fcte-pi1/2026_1_PI1_Grupo2_Lui/src/frontend/README.md

### 1. Pré-requisitos
Você precisa ter o **Node.js** instalado no seu computador. Ele automaticamente inclui o `npm` (gerenciador de pacotes).
[Caso não tenha, baixe a versão LTS do Node.js aqui.](https://nodejs.org/)

### 2. Instalando as Dependências
Abra o seu terminal/prompt de comando diretamente na raiz desta pasta (`src\frontend`) e rode o seguinte comando:

```bash
npm install
```
*O npm vai ler o `package.json`, e baixar automaticamente o React, Tailwind, Lucide e os scripts necessários, criando a pasta `node_modules`.*

### 3. Rodando o Servidor de Desenvolvimento
Uma vez que as dependências terminaram de baixar, basta "ligar" o dashboard com:

```bash
npm start
```

### 4. Acessando a Interface
O comando anterior compilará a interface e abrirá o seu navegador automaticamente. Se não abrir, basta acessar manualmente:
**[http://localhost:3000](http://localhost:3000)**
