fcte-pi1/2026_1_PI1_Grupo2_Lui/docs/index.md

<canvas id="bgCanvas"></canvas>
<style>
  .presentation-title {
    font-size: 5.8rem !important;
  }

  @media screen and (max-width: 76.1875em) {
    .presentation-title {
      font-size: 4.6rem !important;
    }
  }

  @media screen and (max-width: 480px) {
    .presentation-title {
      font-size: 4rem !important;
    }
  }
</style>

#

<div class="presentation">
  <div class="presentation-tag">
    <span class="presentation-line"></span>
    <span class="presentation-label">Arquitetura de Navegação Autônoma</span>
    <span class="presentation-line"></span>
  </div>

  <div class="presentation-title">Micro<br><span class="presentation-title-fade">Mouse</span></div>

  <div class="presentation-content">
    <div class="presentation-text">
      <p style="font-size: var(--home-fs-lead); color: #94a3b8; font-style: italic; line-height: 1.55;">
        Desenvolvimento de um micromouse: um robô autônomo inteligente capaz de explorar e resolver labirintos desconhecidos com alta eficiência. O projeto integra soluções de <strong style="color: #fff;">Energia</strong>, <strong style="color: #fff;">Estrutura</strong>, <strong style="color: #fff;">Hardware</strong> e <strong style="color: #fff;">Software</strong> para criar uma plataforma robusta de navegação autônoma e monitoramento em tempo real.
      </p>
    </div>
  </div>
</div>

---

## Grupo 02 | Turma Lui

<div class="team-areas">

  <!-- ── SOFTWARE (6) ─────────────────────────── -->
  <section class="team-area team-area--software">
    <header class="team-area__header">
      <div class="team-area__title">Software</div>
      <span class="team-area__count">06</span>
    </header>
    <div class="team-area__grid">

      <a class="team-card team-card--lead" data-area="software" href="https://github.com/arthurrochamoreira">
        <span class="team-card__badge">Gerente de Software</span>
        <div class="team-card__avatar-inner">
          Arthur Moreira
        </div>
        <div class="team-card__body">
          <div class="team-card__name">Arthur Moreira</div>
          <div class="team-card__handle">@arthurrochamoreira</div>
        </div>
      </a>

      <a class="team-card" data-area="software" href="https://github.com/eduardoferre">
        <div class="team-card__avatar-inner">
          Eduardo Ferreira
        </div>
        <div class="team-card__body">
          <div class="team-card__name">Eduardo Ferreira</div>
          <div class="team-card__handle">@eduardoferre</div>
        </div>
      </a>

      <a class="team-card" data-area="software" href="https://github.com/flaviarebelato">
        <div class="team-card__avatar-inner">
          Flávia de Melo
        </div>
        <div class="team-card__body">
          <div class="team-card__name">Flávia de Melo</div>
          <div class="team-card__handle">@flaviarebelato</div>
        </div>
      </a>

      <a class="team-card" data-area="software" href="https://github.com/GabrielDiniz12">
        <div class="team-card__avatar-inner">
          Gabriel Diniz
        </div>
        <div class="team-card__body">
          <div class="team-card__name">Gabriel Diniz</div>
          <div class="team-card__handle">@GabrielDiniz12</div>
        </div>
      </a>

      <a class="team-card" data-area="software" href="https://github.com/gpaulovit">
        <div class="team-card__avatar-inner">
          Paulo Vitor
        </div>
        <div class="team-card__body">
          <div class="team-card__name">Paulo Vitor</div>
          <div class="team-card__handle">@gpaulovit</div>
        </div>
      </a>

      <a class="team-card" data-area="software" href="https://github.com/dev-americo">
        <div class="team-card__avatar-inner">
          Pedro H. A.
        </div>
        <div class="team-card__body">
          <div class="team-card__name">Pedro H. A.</div>
          <div class="team-card__handle">@dev-americo</div>
        </div>
      </a>

    </div>
  </section>

  <!-- ── HARDWARE (5) ─────────────────────────── -->
  <section class="team-area team-area--hardware">
    <header class="team-area__header">
      <div class="team-area__title">Hardware</div>
      <span class="team-area__count">05</span>
    </header>
    <div class="team-area__grid">

      <a class="team-card team-card--lead" data-area="hardware" href="#">
        <span class="team-card__badge">Gerente de Hardware</span>
        <div class="team-card__avatar-inner">
          João Victor Pereira
        </div>
        <div class="team-card__body">
          <div class="team-card__name">João Victor Pereira</div>
          <div class="team-card__handle">@joaovitor</div>
        </div>
      </a>

      <a class="team-card" data-area="hardware" href="https://github.com/arthurlleite">
        <div class="team-card__avatar-inner">
          Arthur Carvalho
        </div>
        <div class="team-card__body">
          <div class="team-card__name">Arthur Carvalho</div>
          <div class="team-card__handle">@arthurlleite</div>
        </div>
      </a>

      <a class="team-card" data-area="hardware" href="https://github.com/menali17">
        <div class="team-card__avatar-inner">
          Enzo Menali
        </div>
        <div class="team-card__body">
          <div class="team-card__name">Enzo Menali</div>
          <div class="team-card__handle">@menali17</div>
        </div>
      </a>

      <a class="team-card" data-area="hardware" href="https://github.com/xLucasMelo">
        <div class="team-card__avatar-inner">
          Lucas Alves
        </div>
        <div class="team-card__body">
          <div class="team-card__name">Lucas Alves</div>
          <div class="team-card__handle">@xLucasMelo</div>
        </div>
      </a>

      <a class="team-card" data-area="hardware" href="https://github.com/pwdrinho">
        <div class="team-card__avatar-inner">
          Pedro Lucas
        </div>
        <div class="team-card__body">
          <div class="team-card__name">Pedro Lucas</div>
          <div class="team-card__handle">@pwdrinho</div>
        </div>
      </a>

    </div>
  </section>

  <!-- ── ENERGIA (4) ─────────────────────────── -->
  <section class="team-area team-area--energia">
    <header class="team-area__header">
      <div class="team-area__title">Energia</div>
      <span class="team-area__count">04</span>
    </header>
    <div class="team-area__grid">

      <a class="team-card team-card--lead" data-area="energia" href="https://github.com/gusmoles">
        <span class="team-card__badge">Gerente de Energia</span>
        <div class="team-card__avatar-inner">
          Guilherme Gusmão
        </div>
        <div class="team-card__body">
          <div class="team-card__name">Guilherme Gusmão</div>
          <div class="team-card__handle">@gusmoles</div>
        </div>
      </a>

      <a class="team-card" data-area="energia" href="https://github.com/cvbmiranda">
        <div class="team-card__avatar-inner">
          Caio Vilas Boas
        </div>
        <div class="team-card__body">
          <div class="team-card__name">Caio Vilas Boas</div>
          <div class="team-card__handle">@cvbmiranda</div>
        </div>
      </a>

      <a class="team-card" data-area="energia" href="#">
        <div class="team-card__avatar-inner">
          Theo Medeiros
        </div>
        <div class="team-card__body">
          <div class="team-card__name">Theo Medeiros</div>
          <div class="team-card__handle">@theomedeiros</div>
        </div>
      </a>

      <a class="team-card" data-area="energia" href="https://github.com/viniiribeiro">
        <div class="team-card__avatar-inner">
          Vinicius Ribeiro
        </div>
        <div class="team-card__body">
          <div class="team-card__name">Vinicius Ribeiro</div>
          <div class="team-card__handle">@viniiribeiro</div>
        </div>
      </a>

    </div>
  </section>

  <!-- ── ESTRUTURAS (3) ─────────────────────────── -->
  <section class="team-area team-area--estruturas">
    <header class="team-area__header">
      <div class="team-area__title">Estruturas</div>
      <span class="team-area__count">03</span>
    </header>
    <div class="team-area__grid">

      <a class="team-card team-card--lead" data-area="estruturas" href="https://github.com/heyclarinham">
        <span class="team-card__badge">Gerente de Projeto</span>
        <div class="team-card__avatar-inner">
          Maria Clara
        </div>
        <div class="team-card__body">
          <div class="team-card__name">Maria Clara</div>
          <div class="team-card__handle">@heyclarinham</div>
        </div>
      </a>

      <a class="team-card team-card--lead" data-area="estruturas" href="https://github.com/luisa747">
        <span class="team-card__badge">Gerente de Estruturas</span>
        <div class="team-card__avatar-inner">
          Luisa Mel
        </div>
        <div class="team-card__body">
          <div class="team-card__name">Luisa Mel</div>
          <div class="team-card__handle">@luisa747</div>
        </div>
      </a>

      <a class="team-card" data-area="estruturas" href="https://github.com/nandjala">
        <div class="team-card__avatar-inner">
          Nandjala
        </div>
        <div class="team-card__body">
          <div class="team-card__name">Nandjala</div>
          <div class="team-card__handle">@nandjala</div>
        </div>
      </a>

    </div>
  </section>

</div>

---

## Referências

GARCIA, Diogo C.; RODRIGUES, Juliana P.; NERI, Hilmer Rodrigues; HABL, Lui T. C.; PEREIRA, Bruno L.
**MicroMouse Project**
*Universidade de Brasília (UnB), Faculdade do Gama (FCTE), 2026.*

## Histórico de versões

| Versão | Data | Descrição | Autor(es) | Revisor(es) | Descrição da Revisão |
| :----: | :---: | :---: | :---: | :---: | :---: |
| `1.0`  | 14/04/2026 | Criação da git page | [Arthur Moreira](https://github.com/arthurrochamoreira) | Pendente |  |
