fcte-pi1/2026_1_PI1_Grupo2_Lui/hw/assets/Figura 1 - Implementação do código de processamento..png

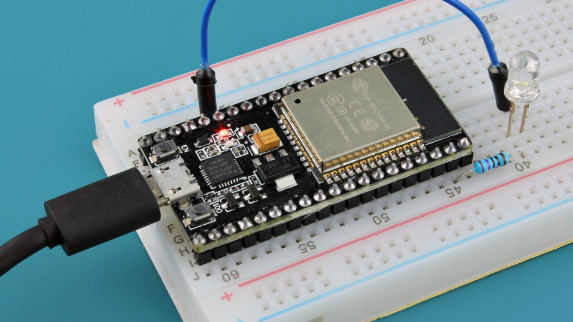
hw/assets/Figura 1 - Implementação do código de processamento..png
