fcte-pi1/2026_1_PI1_Grupo2_Lui/hw/assets/Figura 3 - Diagrama de Estados da FSM implementada no firmware.png

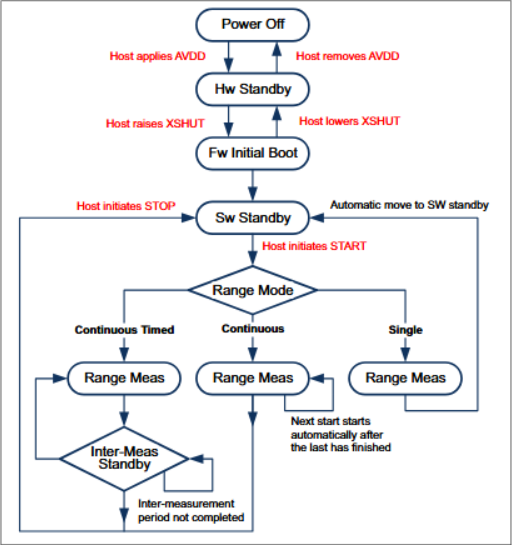
hw/assets/Figura 3 - Diagrama de Estados da FSM implementada no firmware.png
