fcte-pi1/2026_1_PI1_Grupo2_Lui/hw/assets/Figura 4 - Monitor serial distância 3 cm.png

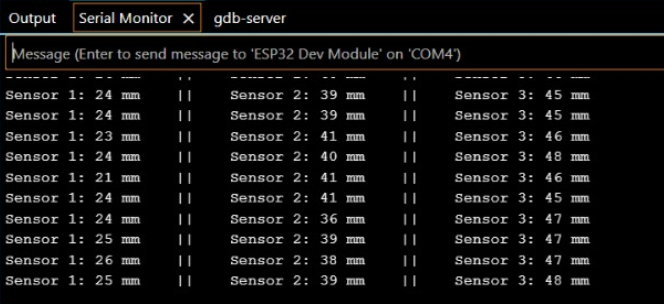
hw/assets/Figura 4 - Monitor serial distância 3 cm.png
