fcte-pi1/2026_1_PI1_Grupo2_Lui/hw/assets/Figura 5 - Monitor serial distância 5 cm.png

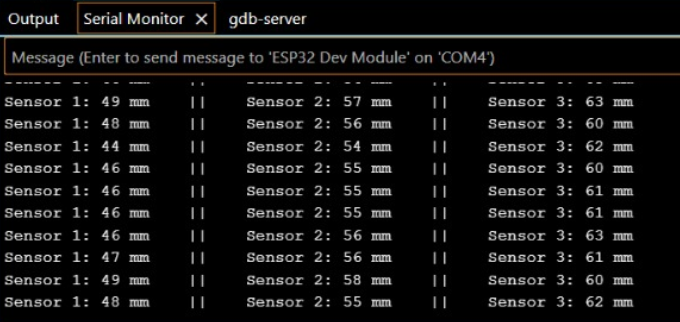
hw/assets/Figura 5 - Monitor serial distância 5 cm.png
