fcte-pi1/2026_1_PI1_Grupo2_Lui/hw/assets/Figura 6 - Monitor serial distância 15 cm.png

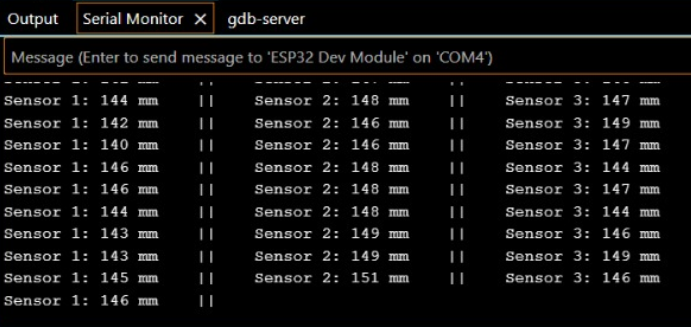
hw/assets/Figura 6 - Monitor serial distância 15 cm.png
