fcte-pi1/2026_1_PI1_Grupo2_Lui/hw/assets/Figura 7 - Monitor serial distância 18 cm.png

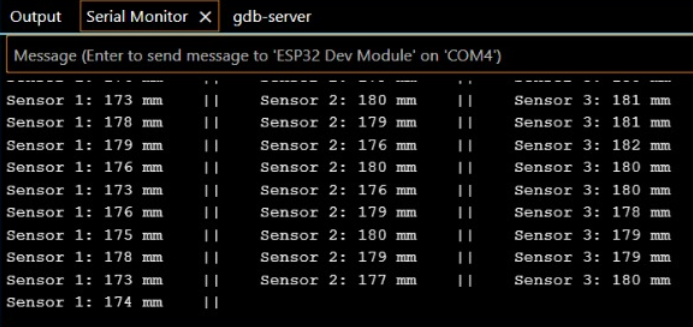
hw/assets/Figura 7 - Monitor serial distância 18 cm.png
