fcte-pi1/2026_1_PI1_Grupo2_Lui/hw/assets/Figura 8 - Monitor serial distância 25 cm.png

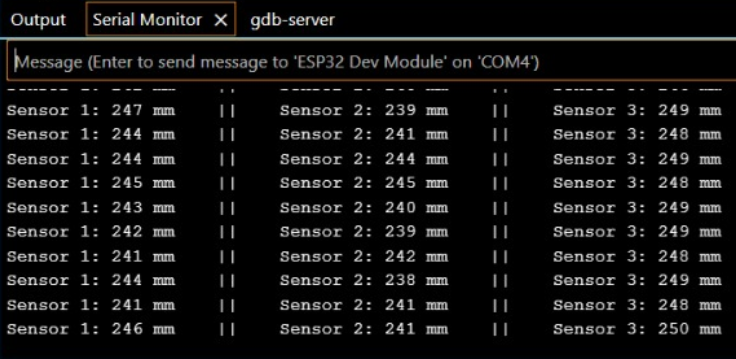
hw/assets/Figura 8 - Monitor serial distância 25 cm.png
