fcte-pi1/2026_1_PI1_Grupo2_Lui/hw/assets/Figura 12 - Diagrama do circuito.png

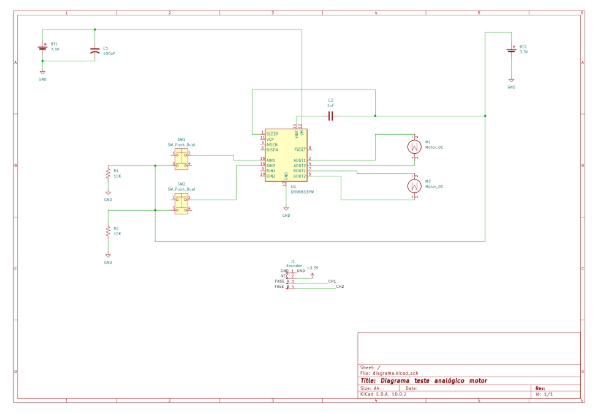
hw/assets/Figura 12 - Diagrama do circuito.png
