fcte-pi1/2026_1_PI1_Grupo2_Lui/hw/assets/Figura 13.1 - Tela do osciloscópio do laboratório.png

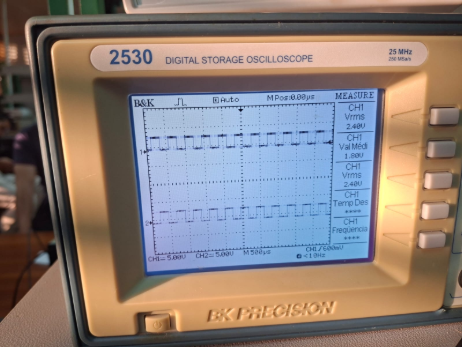
hw/assets/Figura 13.1 - Tela do osciloscópio do laboratório.png
