fcte-pi1/2026_1_PI1_Grupo2_Lui/hw/assets/inicio_codigo.png

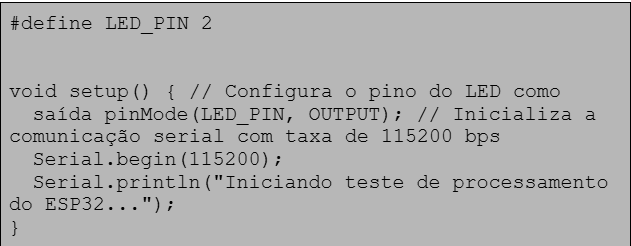
hw/assets/inicio_codigo.png
