fcte-pi1/2026_1_PI1_Grupo2_Lui/hw/assets/loop_codigo.png

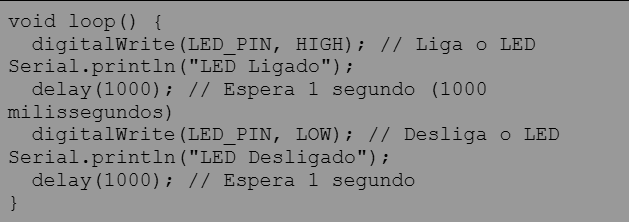
hw/assets/loop_codigo.png
