fcte-pi1/2026_1_PI1_Grupo2_Lui/hw/curva_sharp.jpg

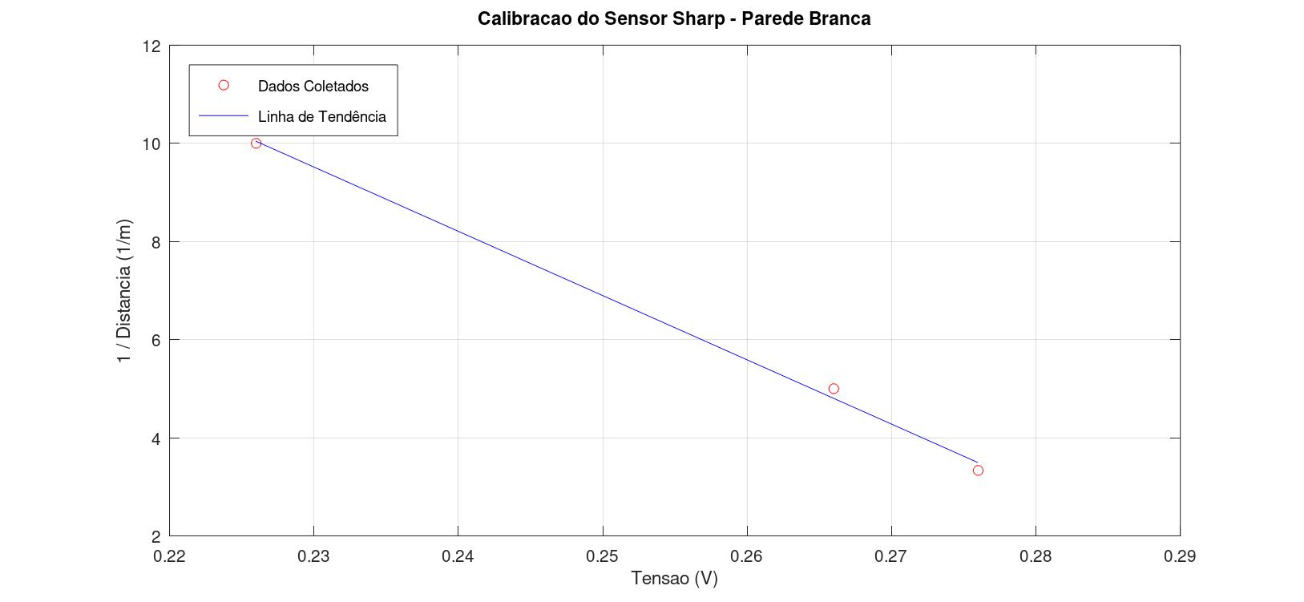
hw/curva_sharp.jpg
