fcte-pi1/2026_1_PI1_Grupo2_Lui/hw/diagrama_bloco.png

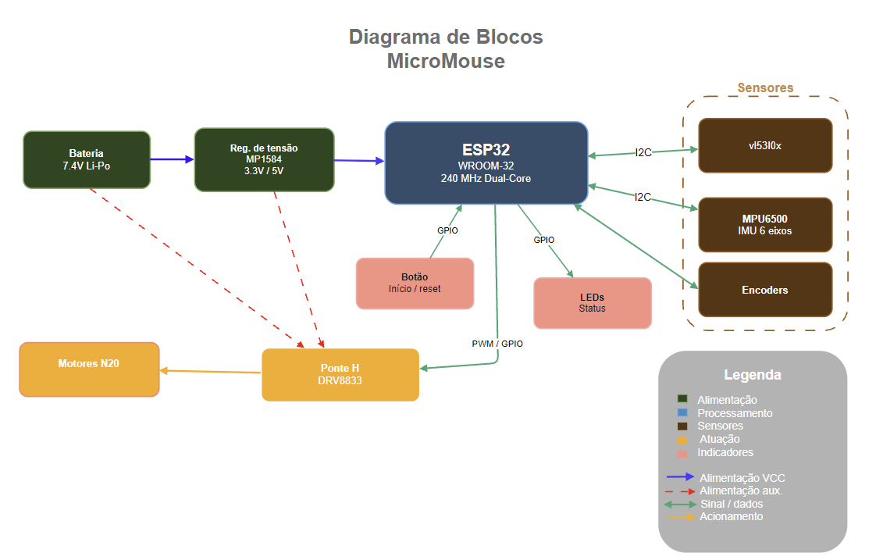
hw/diagrama_bloco.png
