fcte-pi1/2026_1_PI1_Grupo2_Lui/mec/labirinto/labirinto-foto-03.jpeg

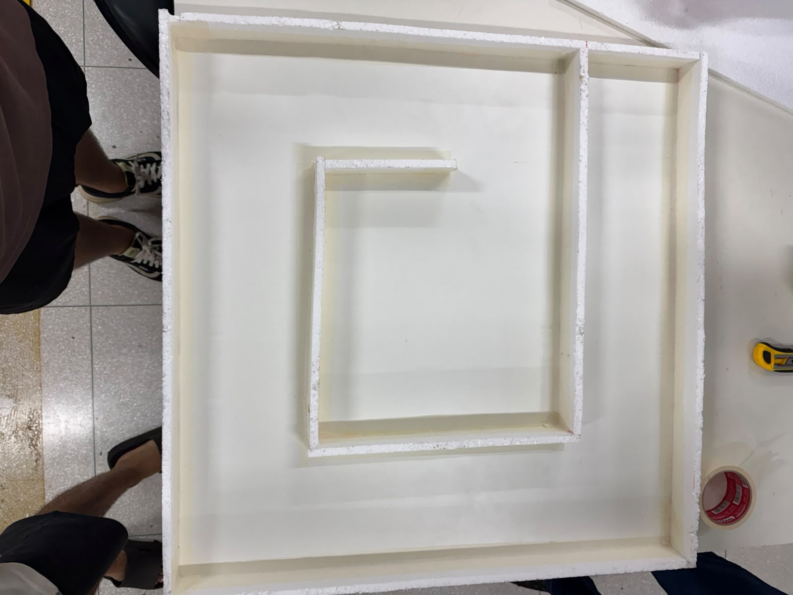
mec/labirinto/labirinto-foto-03.jpeg
