fcte-pi1/2026_1_PI1_Grupo2_Lui/docs/estrutura/labirinto.stl

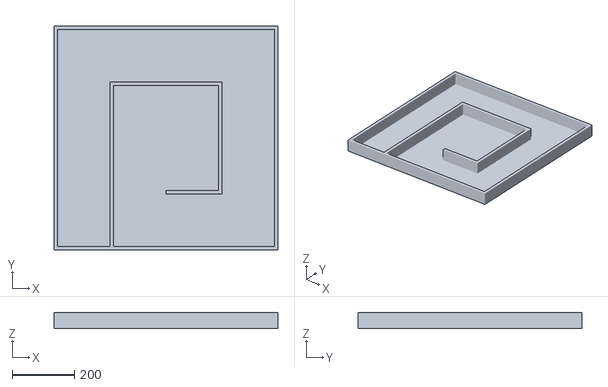
[picture p26: CAD file, 2026-06-03]
docs/estrutura/labirinto.stl
720.0 x 720.0 x 52.0
