fcte-pi1/2026_1_PI1_Grupo2_Lui/mec/labirinto/construcao-labirinto.md

# Construção do Labirinto — Micromouse

Este labirinto foi construído com as mesmas proporções que serão utilizadas na apresentação final do projeto, onde os professores apresentarão um desafio ao micromouse.

## Materiais Utilizados

- **Base:** madeira MDF já lixada e pintada de branco (comprada pronta)
- **Paredes:** isopor cortado nas dimensões corretas das células do labirinto
- **Cola de madeira:** utilizada para fixar as paredes de isopor à base
- **Cola de isopor:** aplicada sobre a cola de madeira antes de posicionar cada parede
- **Palitos de dente:** inseridos nas junções entre as paredes para reforçar as conexões
- **Fita adesiva:** aplicada por cima dos palitos para reforço adicional

## Processo de Montagem

1. Cortamos o isopor nas dimensões corretas das paredes do labirinto.
2. Aplicamos cola de madeira na base nos pontos onde cada parede seria fixada.
3. Sobre a cola de madeira ainda fresca, aplicamos cola de isopor.
4. Posicionamos cada parede de isopor sobre a cola e aguardamos a fixação.
5. Reforçamos todas as conexões entre paredes com palitos de dente.
6. Finalizamos passando fita adesiva sobre as junções para garantir maior estabilidade.

## Fotos e Vídeos

As fotos e vídeos da montagem e do labirinto finalizado estão nesta mesma pasta:

- [labirinto-foto-01.jpeg](labirinto-foto-01.jpeg)
- [labirinto-foto-02.jpeg](labirinto-foto-02.jpeg)
- [labirinto-foto-03.jpeg](labirinto-foto-03.jpeg)
- [labirinto-video-01.mp4](labirinto-video-01.mp4)
- [labirinto-video-02.mp4](labirinto-video-02.mp4)
- [labirinto-video-03.mp4](labirinto-video-03.mp4)
- [labirinto-video-04.mp4](labirinto-video-04.mp4)

## Equipe Presente na Montagem

| Integrante | Área |
|---|---|
| [arthurlleite](https://github.com/arthurlleite) | Software / Eletrônica |
| [nandjala](https://github.com/nandjala) | Estrutura |
| [dev-americo](https://github.com/dev-americo) | Software |
| [gusmoles](https://github.com/gusmoles) | Energia |
| [cvbmiranda](https://github.com/cvbmiranda) | Software |
| [heyclarinham](https://github.com/heyclarinham) | Estrutura |
