fcte-pi1/2026_1_PI1_Grupo2_Lui/docs/estrutura/labirinto_de_testes.md

## Labirinto de Testes 4X4
