fcte-pi1/2026_1_PI1_Grupo2_Lui/hw/assets/Figura 9 - Curva de calibração dos sensores TOF feita em Matlab.png

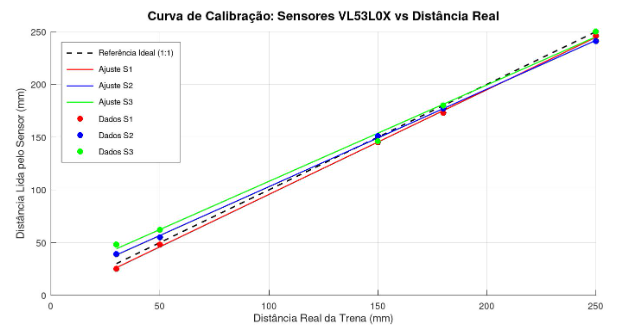
hw/assets/Figura 9 - Curva de calibração dos sensores TOF feita em Matlab.png
