fcte-pi1/2026_1_PI1_Grupo2_Lui/hw/assets/Figura 10 - Teste de bancada com ponte H.png

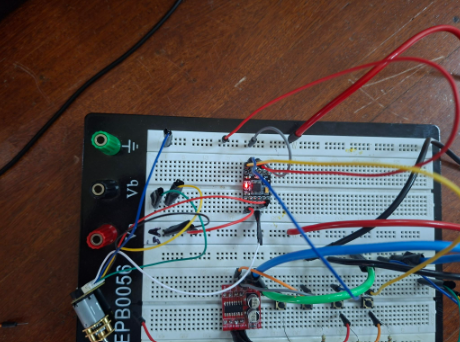
hw/assets/Figura 10 - Teste de bancada com ponte H.png
