fcte-pi1/2026_1_PI1_Grupo2_Lui/hw/assets/Figura 11 - Teste de validação dos motores.png

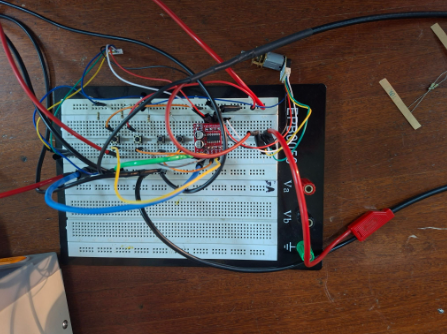
hw/assets/Figura 11 - Teste de validação dos motores.png
