fcte-pi1/2026_1_PI1_Grupo2_Lui/hw/curva de calibragem MPU6500.jpeg

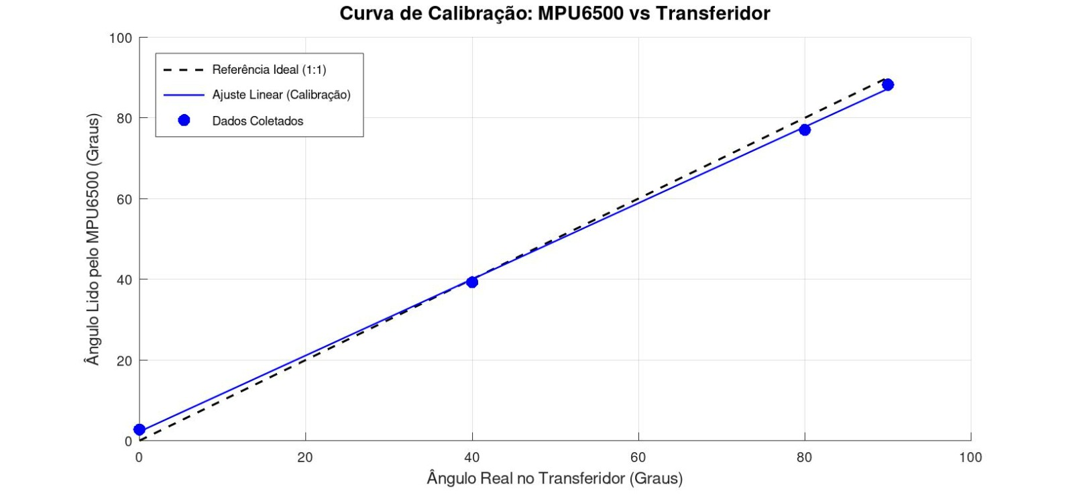
hw/curva de calibragem MPU6500.jpeg
