fcte-pi1/2026_1_PI1_Grupo2_Lui/hw/diagrama.pdf

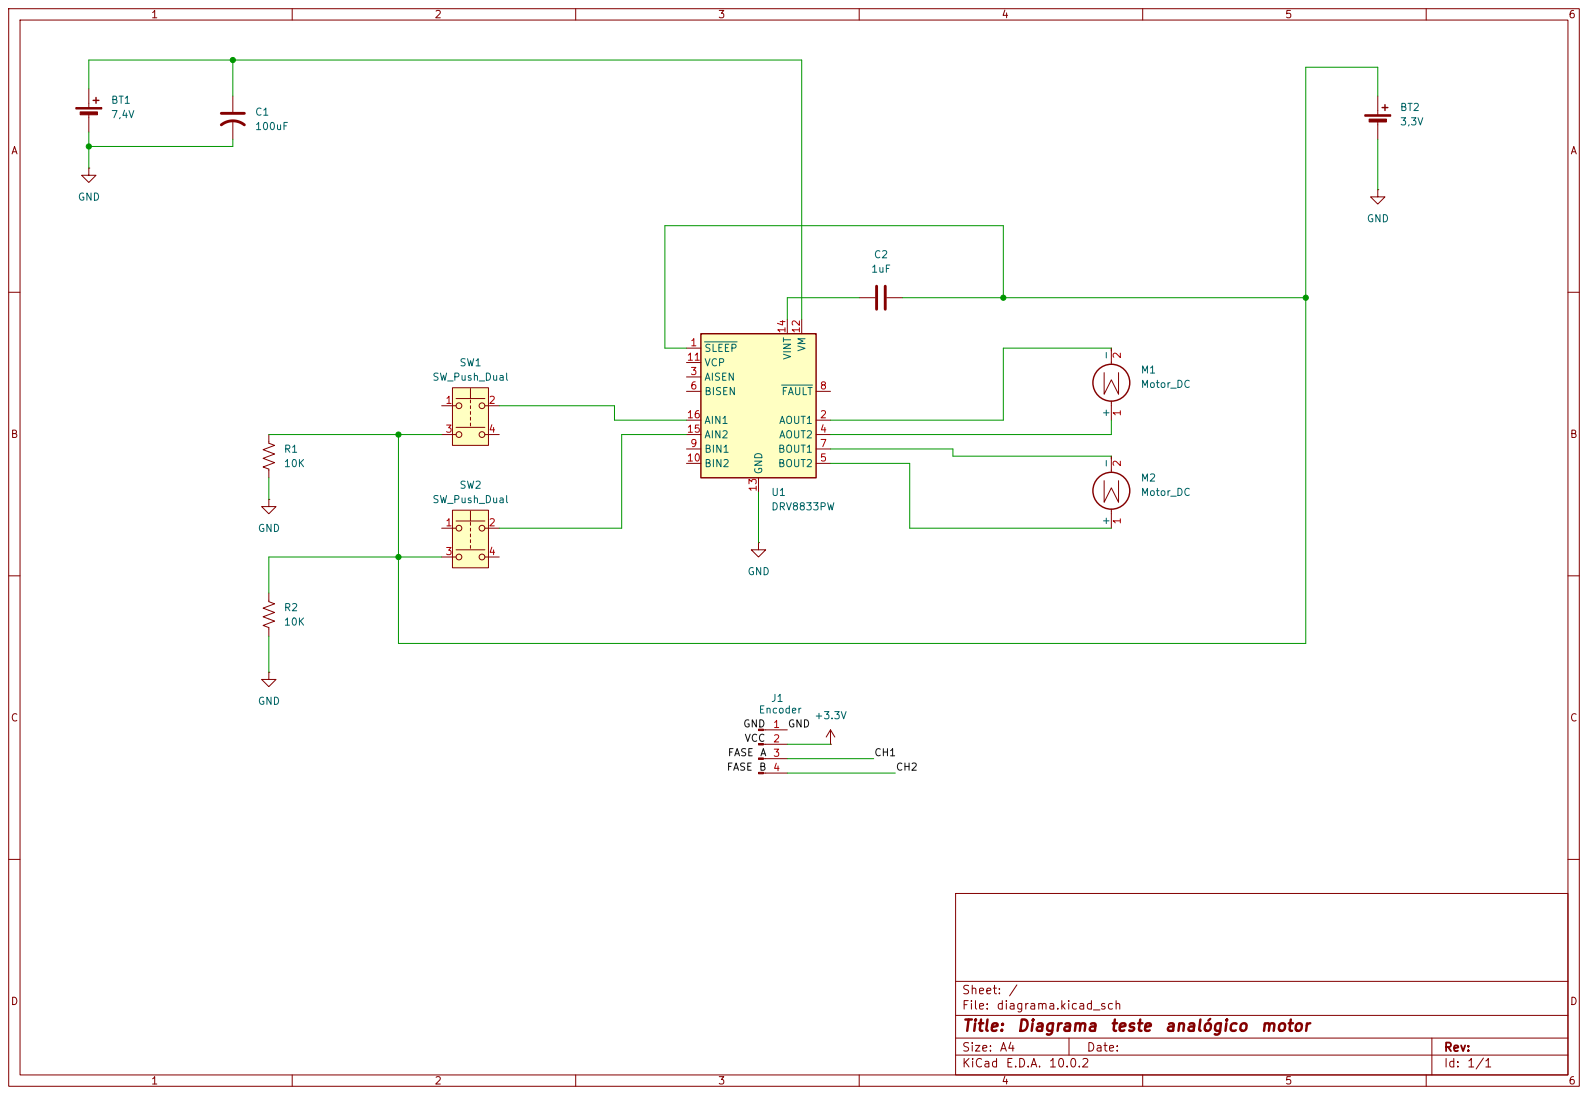
[picture p31: page 1]

Sheet: /
File: diagrama.kicad_sch
Title: Diagrama teste analógico motor

Size: A4 | Rev:
KiCad E.D.A. 10.0.2 | Id: 1/1
