fcte-pi1/2026_1_PI1_Grupo2_Lui/src/firmware/mpu/mpu.h

#ifndef MPU_H
#define MPU_H

#include <Arduino.h>

// Inicializa o sensor MPU-6500 e configura suas escalas
void configurarMPU();

// Lê e exibe a Aceleração (X, Y) e o Giroscópio (Z)
void lerExibirMPU();

#endif

/*

Quando For implementar a main.cpp

void setup() {
  Serial.begin(115200);
  // Outras configurações...
  Serial.println("[Micromouse] Configurando MPU-6500...");
  configurarMPU();
}

void loop() {
  // Outras lógicas...
  lerExibirMPU();
  // Outras lógicas...
  //divisor
  Serial.println("--------------------------------------------------");
}

*/
