fcte-pi1/2026_1_PI1_Grupo2_Lui/src/firmware/encoder/test_encoder.cpp

#ifndef TEST_ENCODER_H
#define TEST_ENCODER_H

// Executa o roteiro de testes do CT-05.
// Chamar no setup() do main.cpp durante validação.
// Remover a chamada após aprovação no hardware físico.
void test_encoder_run();

#endif // TEST_ENCODER_H
