fcte-pi1/2026_1_PI1_Grupo2_Lui/(commit log)

2026-04-27 docs: remove req de 10k registros para alinhar com regras da disciplina
    Os slides da disciplina exigem que os dados sejam salvos no banco apenas
    "após a conclusão do desafio" (Slide 9). A gravação contínua não atende
    a esse requisito e viola o CT-20. O sistema exibirá a telemetria em tempo
    real, mas persistirá apenas os dados consolidados ao fim da corrida.
2026-04-29 fix: eleva prioridades de US09 e US12
2026-05-01 docs: atualização dos criterios de aceitação da US10
2026-05-03 mkdocs: botão de voltar ao topo
2026-05-04 docs: Commit inicial dos Casos de Uso e Diagrama UML
2026-05-04 fix: Atualização do documento de casos de uso e adição de classe mermaid a renderização da página
2026-05-05 doc/Adiciona diagrama de blocos ao repositório
2026-05-05 Rename Relatório de pesquisa_ determinar a altura do chassi as rodas.pdf to Determinar a altura do chassi as rodas.pdf
2026-05-05 Selecao_de_materiais_para_chassi
    Descrição de análise de material especificamente para o desenvolvimento do chassi
2026-05-05 css e js: correções de estilo; ajusta respiro e layout dos cards da equipe
2026-05-07 docs: adição de estados frontend
2026-05-08 docs(bpmn): simplifica texto para refletir o diagrama
2026-05-08 docs(atividades): renomeia arquivos de bpmn para diagrama de atividades
2026-05-08 fix/Ajusta diagrama de blocos
2026-05-11 docs: Refinamento seção Diagrama de Arquitetura e adição do Diagrama UML
2026-05-11 patch: correções de texto para a versão latex do pc1
2026-05-12 docs: atualiza documentação, relatório e embeds de diagramas
    - ajusta arquivos Markdown da seção de software
    - adiciona protótipo funcional da interface
    - corrige embeds e caminhos de SVGs dos diagramas
    - inclui assets relacionados ao relatório e à documentação
2026-05-20 fw: adiciona mapeamento de pinos (pins.h)
2026-05-27 feat(firmware): rotina de teste individual dos motores — Tarefa 7.1.1
2026-05-28 feat: adição de .h para sensor de distância
2026-05-28 feat: adição de funções para inicialização e leitura para sensor de distância
2026-05-28 feat: adição de .h para sensor mpu
2026-05-28 feat: adição de .cpp com função de inicialição e leitra para sensor mpu
2026-05-28 adiciona encoder.h
2026-05-28 adiciona encoder.cpp
2026-05-29 refactor: move encoder into separate module folder
2026-06-01 feat(hw): Diagrama a ser seguido em teste analógico dos motores DC
2026-06-02 chore: configura ambiente de testes e wokwi (#7.1.2)
2026-06-02 feat: implementa funções básicas de movimento (Fase GREEN) (#7.1.2)
2026-06-02 feat: implementa controle de velocidade via PWM (0-100%)
2026-06-02 feat: cria endpoint de telemetria e testes automatizados
2026-06-03 feat: adiciona renderizador 3D de arquivos stl para a gitpage
2026-06-03 docs: migra documentacao de mecanica para a pasta docs e atualizar caminhos no menu
    [labirinto.stl]
2026-06-03 docs(estrutura): migrar documentacao de mecanica para a pasta docs e atualizar caminhos no menu
    [labirinto.stl]
2026-06-03 fix: limpeza de comentarios
2026-06-04 feat: Criação de código de teste para os sensores de proximidade
2026-06-04 feat(frontend): criar dashboard inicial e portar lógica de Flood Fill do C++
    - Criar estrutura base do App em React com divisão de Mapa e Telemetria
    - Implementar controles interativos e simulação visual com Tailwind CSS
    - Adicionar botão "Conectar" no cabeçalho para futura integração com o ESP32
    - Adaptar algoritmo Flood Fill do C++ para o simulador React, incluindo fechamento de dead-ends e prioridade direcional
2026-06-05 feat: adiciona mock de historico
2026-06-05 docs: arquivo MD com contrato de telemetria
2026-06-05 feat: estruturando banco de dados e arquitetura do backend
2026-06-05 feat: implementar persistencia e historico de corridas
2026-06-05 docs: adiciona instruções para compilação do relatório LaTeX
2026-06-05 feat: adiciona WebSocket para transmissão de telemetria em tempo real
2026-06-06 adiciona testes automatizados de histórico e filtros (CT-28, CT-29)
2026-06-06 add testes automatizados de histórico e filtros (CT-28, CT-29)
2026-06-06 add data-testid no App.js para suporte aos testes Playwright
2026-06-06 test: atualiza testes do histórico para refletir o estado atual do App.js
2026-06-06 fix(tests): corrige seletor data-testid de historico-corridas para historico-view
2026-06-06 fix(backend): corrigir pipeline de telemetria e histórico.
    Inclui:
    - inverter ordem broadcast → persist (CT-19)
    - adicionar endpoint /health
    - persistência de source/success
    - endpoint GET /historico/{id}
    - persistência de known_walls
    [app.py]
2026-06-06 feat(schema): atualizar contrato de telemetria
    - RaceStatusEnum aceita ready e paused
    - adicionar campos source e success
    - adicionar campo known_walls
    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
2026-06-06 feat(database): suportar replay e metadados de corrida
    - migração para source
    - migração para success
    - migração para known_walls
    - consulta de replay por id
    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
2026-06-06 feat(sim): expandir simulador de corrida
    - path tracking
    - bateria simulada
    - envio de known_walls
    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
2026-06-06 feat(api): criar camada de integração frontend-backend
    - getHistorico()
    - postTelemetria()
    - helpers de API
    - suporte replay
    - suporte known_walls
    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
2026-06-06 feat(scripts): criar emulador de firmware
2026-06-06 docs(contrato): atualizar especificação de telemetria
2026-06-06 feat(mec): adiciona analise de rigidez e ruido estrutural
2026-06-06 chore(test): infra de testes e cobertura
    - Make: alvos test, test-backend, test-frontend, test-frontend-e2e,
    test-coverage, coverage-backend, coverage-frontend, install-backend,
    install-frontend.
    - scripts/run_backend_tests.py e run_frontend_tests.py: wrappers em
    Python pra não quebrar no cmd/PowerShell.
    - backend: pytest.ini + .coveragerc com pytest-cov 70% (HTML/XML).
    - frontend: package.json com test:unit/ci/coverage/e2e e jest
    coverageThreshold 70%.
    - README raiz + src/README com guia de execução.
    - .gitignore: coverage/, coverage_html/, coverage.xml, .pytest_cache.
2026-06-06 Adiciona relatório de solda e pinagem
2026-06-06 testes: adiciona os testes do dashboard que faltavam
2026-06-06 teste de telemetria
2026-06-06 test(frontend): adiciona testes unitários e eleva cobertura para ~70%
    Cria suítes Jest para as camadas de lógica e UI do dashboard, cobrindo
    casos da matriz de testes funcionais (navegação, telemetria, persistência
    e mapeamento):
    - api.test.js: formatadores, conversão de bateria, mapeamento de corridas
    e chamadas HTTP (getHistorico com filtro/Todos/vazio, postTelemetria,
    getHealth, getCorrida) com fetch mockado
    - useWebSocket.test.js: conexão automática, parse de mensagens e reconexão
    - useMazeSimulator.test.js: geração de labirinto, flood fill, escrita de
    mapa, navegação até o centro e estado "Preso!" (RNG determinístico)
    - App.test.js: abas, controles do mapa, teleme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
2026-06-06 fix(build): evita criação de arquivo "NUL" na detecção de SO do Makefile
2026-06-06 Atualiza README com detalhes de execução dos testes de frontend e backend.
2026-06-06 feat: adiciona alvos make para rodar e instalar backend/frontend
    - run-backend e run-frontend via wrappers em scripts/
    - install-deps para instalar as duas stacks de uma vez
    - README com seção de execução da aplicação
2026-06-07 feat(frontend): padroniza interface com design system global baseado em tokens
    Unifica espaçamento, arredondamento, altura, alinhamento, contraste e
    tipografia de todos os componentes do dashboard, eliminando paddings
    desproporcionais, alturas inconsistentes e textos de baixo contraste.
    - index.css: tokens globais de spacing (--space-1..6), radius
    (--radius-sm..xl + pill), altura de controle (--control-h-sm/md/lg),
    ícone, gap e tipografia por categoria; regra do raio interno explícita
    (--pill-radius-inner = calc(outer - padding)); novas utilities .badge,
    .control-md e .text-* (page-title/section/label/btn/nav/chip/value/
    unit/caption/data) com flex + box-sizing, sem offsets man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
2026-06-07 docs: Adiciona relatório do Regulador de Tensão
2026-06-07 feat(ui): adiciona switch para alternar entre modo Simulador e Corrida no painel
2026-06-07 feat(ui): refinamentos de componentes, layout e testes
    - Substitui `<select>` nativos por componente `CustomSelect` estilizado
    - Remove `overflow: hidden` de `.pill-container` para corrigir renderização de dropdowns
    - Aplica `rounded-[16px]` nos seletores para manter a padronização das pílulas
    - Adiciona larguras fixas em botões de texto dinâmico evitando layout shift
    - Atualiza e expande testes de regressão do Design System (`designSystem.test.js`) e UI (`App.test.js`)
2026-06-07 test(e2e): adapta testes do playwright para a nova UI e componentes customizados
2026-06-07 feat(ui): reformula view de ranking para formato tabular e adiciona atalhos de replay
    - **Ranking Unificado em Tabela**: Substituída a exibição antiga em formato de grid (separada por labirinto) por uma tabela contínua ordenada por melhor tempo.
    - **Pódio Visual Integrado**: Linhas da tabela (1º, 2º e 3º) receberam indicadores visuais de pódio via `border-l` e highlight nas cores Ouro, Prata e Bronze. Trocado ícone de primeiro lugar por marcador circular dourado.
    - **Filtro de Fonte**: Adicionado um controle `pill-container` dedicado (Todos / Físico / Simulador) no Ranking para isolar hardware x simulador.
    - **Aviso de Click-to-Replay**: Implementada coluna extra com ícone `Chevr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
2026-06-07 Fix (Testes): Atualizados os expects no `App.test.js` para refletir as novas labels ("Ranking Geral") implementadas no painel.
2026-06-07 feat: implementa aba de Configurações completa (WebSocket dinâmico, CSV e Reset)" -m "Backend: - Adiciona rota DELETE /historico em app.py - Cria função limpar_banco() em database.py Frontend: - Cria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
    [app.py]
2026-06-07 mec: adiciona documentação de construção do labirinto com materiais e equipe
2026-06-07 hw: adiciona PDF compilado do relatório VL53L0X — PC2
2026-06-07 Add gyroscope sensor code for ESP32
2026-06-07 style: padroniza botões, selects e painel de status da UI
    - Atualiza o border-radius de inputs e botões na tela de Configurações para `rounded-xl`, mantendo consistência com o Design System.
    - Fixa a largura das tags de status na barra lateral (Telemetria) para `w-[130px]`, evitando variações de tamanho ao mudar de texto.
    - Padroniza as dimensões dos botões de salvar em Configurações para tamanhos fixos (`w-48 h-[42px]`) e com alinhamento flexível.
    - Refatora os elementos nativos `<select>` em favor do componente `<CustomSelect>` na tela de Configurações e no ReplayCanvas para consistência visual.
    - Adiciona teste de regressão em `designSystem.test.js` para garantir o uso exc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
2026-06-07 feat(hw): código consertado para funcionamento dos sensores VL53L0X
2026-06-08 Add gyroscope calibration script for MPU6500
    This script calibrates the MPU6500 gyroscope using real angle measurements and displays the calibration results along with a plot comparing measured and ideal angles.
2026-06-08 feat(hw): envio do código de ajuste por regressão linear
2026-06-08 feat(hw): envio do código para teste de pwm no hardware.
2026-06-08 test: adiciona testes pendentes para fluxo de telemetria
2026-06-10 docs: atualiza arquitetura e RE-07 para React e Tailwind
2026-06-10 fix(backend): restringe DELETE /historico à máquina do servidor (RNF-10)
    [app.py]
2026-06-10 feat: implementa decodificacao de comandos via JSON
2026-06-11 feat: implementa encaminhamento de comandos para o ESP32
2026-06-11 feat: trata falhas de comunicacao com ESP32 retornando HTTP 503
2026-06-12 feat(telemetria): pipeline completo ESP32 -> Bluetooth -> backend -> dashboard
    Firmware (arduino/telemetria_bancada + src/firmware):
    - Telemetria via Bluetooth SPP conforme src/contrato_telemetria.md
    (~6,7 Hz, não-bloqueante, pacote final com success e known_walls;
    race_status=error em falha/reset)
    - Corrida simulada com a mesma lógica do simulador do dashboard
    (labirinto aleatório DFS + loops, flood fill, inferência de becos)
    - Comandos "start <4|8|16>" e "reset" via serial/BT; matriz definida
    pelo seletor do dashboard; USB_TELEMETRY para alternar USB/BT
    Ponte (scripts/bt_bridge.py):
    - Lê NDJSON da COM (BT ou USB), carimba timestamp ISO 8601 com ms e
    repassa via POST /teleme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
    [app.py, main_telemetria.cpp, telemetria.cpp, telemetria.h, telemetria_bancada.ino]
2026-06-12 fix: redirecionando código de tese de motores
    [teste.cpp]
2026-06-12 feat: inicio automatico de loop para verificação de sensores
2026-06-22 feat(backend): ponte serial e atualização do contrato de telemetria
    Adiciona serial_bridge.py (ponte serial gerida pelo backend, com injeção
    de telemetria e envio de comandos) e atualiza o contrato de telemetria.
2026-06-22 cria espService com sendConnectCommand para envio ao backend
2026-06-24 add indicador Online/Offline do ESP32 no dashboard
2026-06-24 add lógica de status do ESP32 com timeout e endpoint /esp32/status
    Added ESP32 status endpoint and telemetry tracking.
2026-06-24 docs: atualiza caminho da documentação de comunicação com ESP32
2026-06-25 add funções de movimento preciso com encoder
2026-06-25 substitui movimento por tempo por sistema baseado em encoder
2026-06-30 feat: Adição das funções da leitura e verificação de parede dos sensores
